minch-dev/PhotoShutter/README.md

# PhotoShutter
An automatic shutter/relay based on attiny2313 microcontroller. Supports "pressing" the buttons using an electromechanical relay and IR remote functionality at the same time. All the details are in the schematics folder.

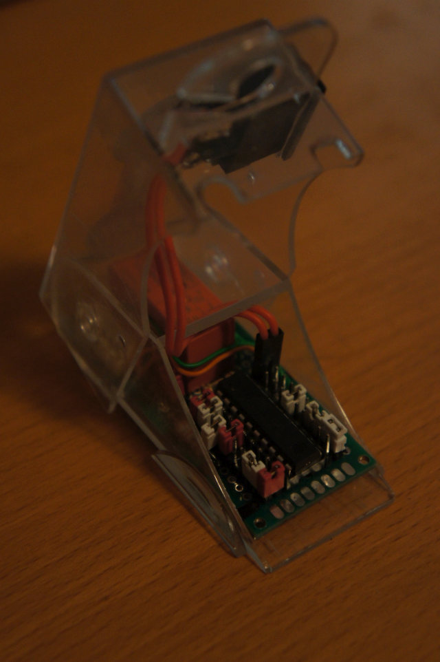
[picture p1: photo/PSHTTR01.JPG]
PhotoShutter in all it's glory
