minch-dev/PhotoShutter/photo/PSHTTR02.JPG

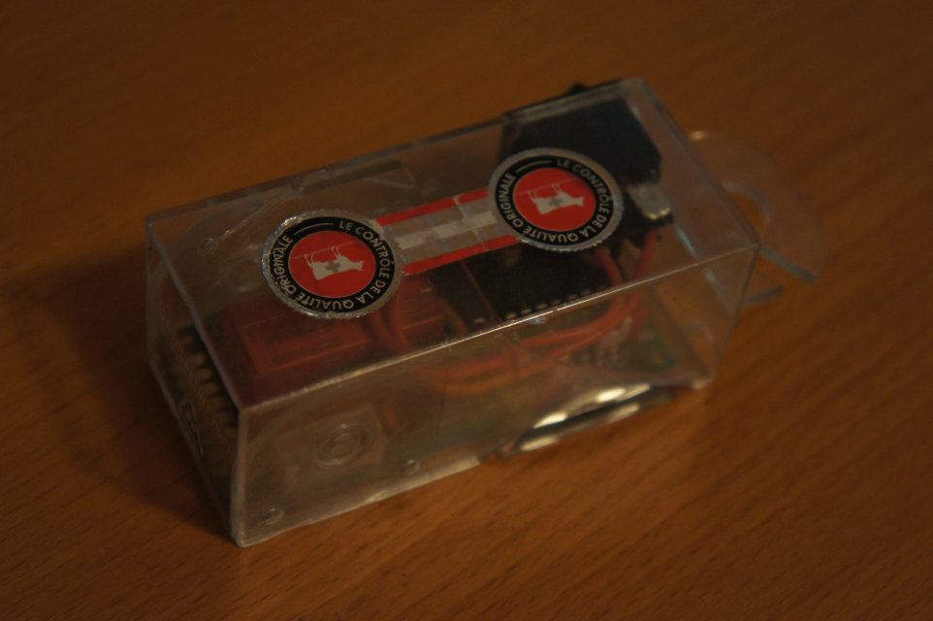
photo/PSHTTR02.JPG
