minch-dev/PhotoShutter/photo/PSHTTR03.JPG

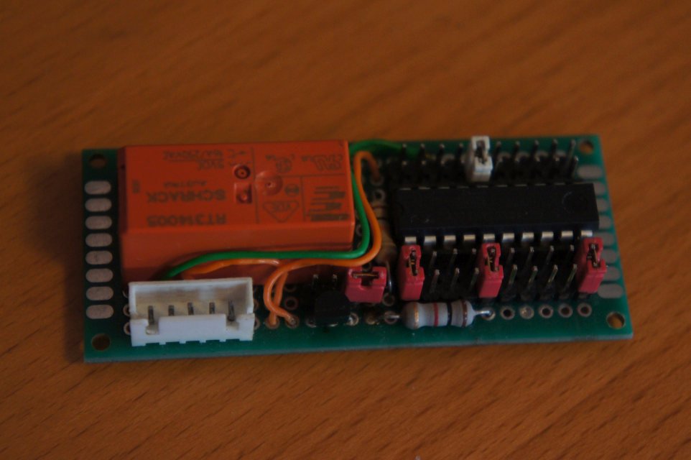
photo/PSHTTR03.JPG
