minch-dev/PhotoShutter/photo/PSHTTR04.JPG

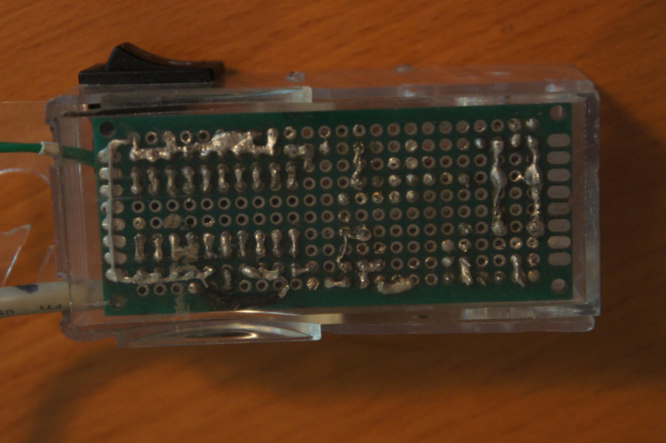
photo/PSHTTR04.JPG
