minch-dev/PhotoShutter/photo/PSHTTR05.JPG

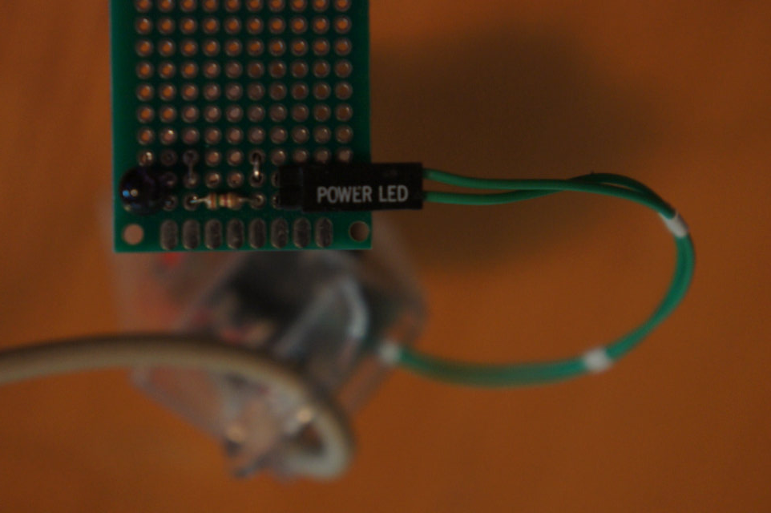
photo/PSHTTR05.JPG
