minch-dev/PhotoShutter/schematics/photoshutter.schematics.pdf

## RELAY

## TEST

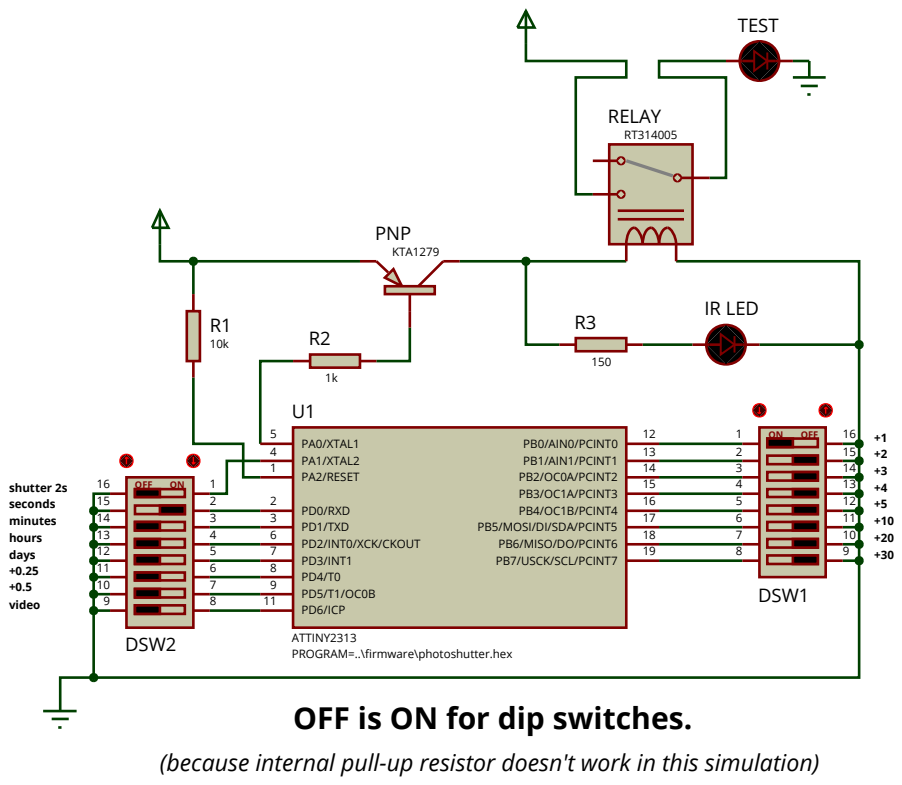
[picture p6: page 1]
PB5/MOSI/DI/SDA/PCINT5; PB6/MISO/DO/PCINT6; PB7/USCK/SCL/PCINT7; PB4/OC1B/PCINT4; 16 PB3/OC1A/PCINT3; 15 PB2/OC0A/PCINT2; 14 PB1/AIN1/PCINT1; 13 PB0/AIN0/PCINT0; PA2/RESET; PA1/XTAL2; PA0/XTAL1; PD0/RXD; PD1/TXD; PD3/INT1; PD2/INT0/XCK/CKOUT; PD6/ICP; ATTINY2313 PROGRAM=..\firmware\photoshutter.hex; PNP; KTA1279; IR LED; OFF; DSW1; DSW2; shutter 2s seconds minutes hours days +0.25 +0.5 video; OFF is ON for dip switches.

(because internal pull-up resistor doesn't work in this simulation)
