minch-dev/PhotoShutter/(list of files, drawings)

Other design files:
schematics/photoshutter.proteus.dsn
