minch-dev/PhotoShutter/(commit log)

2022-01-26 first version of firmware with hardware relay as a shutter button switcher. Was occasionally in development from 2018.02.26 to 2021.01.29
    [shutter.DSN]
2022-01-26 all done but there is a problem with IR leds I have, they hardly light up if at all :/ maybe mc isn't powerful enough to power them up, idk.
    [photoshutter.c]
2022-01-26 both IR LED and relay are on the same pin now - this way i can avoid adding another transistor and resistor for LED (personally hate calculating those)
    [photoshutter.c]
2022-01-28 everything works, even interval switches, as per initial plan. Although Sony Nex doesn't respond to IR commands, might be a problem with sequences or a transistor being sorta slow. Go figure.
    [photoshutter.c]
2022-01-31 final version for now, everything works as intended, finally added pinout and electronic schematics in pdf format
    [photoshutter.proteus.dsn, shutter.DSN]
2022-08-20 added a new `shutter once in x sec` mode, also minor fix
    [photoshutter.c]
